kattlelattle/kindle-page-turner/hardware/pcb/rx/rx_bom.xlsx

Name | Description | Designator | Footprint | LibRef | Quantity
EEUFR1A102L | Aluminum electrolytic capacitor, 1000uF ±20%, 10V, radial | C1 | FP-RAD-TH-D_8_0_5-L_15_1-MFG | CMP-05427-001033-1 | 1
87224-3 | 3-position vertical male header, 2.54mm pitch, through-hole | J1 | FP-87224-3-MFG | CMP-2000-05697-2 | 1
Seeed Studio XIAO ESP32-C3 | ESP32-C3 development board with Wi-Fi and BLE | U1 | MOUDLE14P-2-54-21X17-8MM | Seeed Studio XIAO ESP32-C3 | 1
Adafruit MiniBoost 5V 1A | TPS61023 boost-converter breakout for servo power | U2 | PCBCOMPONENT_1 | Adafruit MiniBoost 5V 1A | 1
1x7 Female Socket Header, 2.54mm | Single-row 7-position female socket header, through-hole | — | 1x7 THT, 2.54mm pitch | TBD | 2
