kattlelattle/kindle-page-turner/hardware/pcb/tx/tx_bom.xlsx

Line # | Name | Description | Designator | Revision ID | Revision State | Revision Status | Quantity | Manufacturer 1 | Manufacturer Part Number 1 | Manufacturer Lifecycle 1 | Supplier 1 | Supplier Part Number 1 | Supplier Unit Price 1 | Supplier Subtotal 1
 | B3F-4000 | SWITCH TACTILE SPST-NO 0.05A 24V | SW1 |  | Unknown server |  | 1 | Omron | B3F-4000 | Volume Production | RS (Formerly Allied Electronics) | B3F-4000 | 0.22 | 0.22
 | Seeed Studio XIAO ESP32-C3 | Wi-Fi/BLE development board | U1 |  | Not managed |  | 1 | Seeed Studio | 113991054
 | 3.7 V 400 mAh LiPo | Rechargeable LiPo battery |  |  |  |  | 1
