kattlelattle/kindle-page-turner/hardware/enclosure/rx/rx_arm.stl

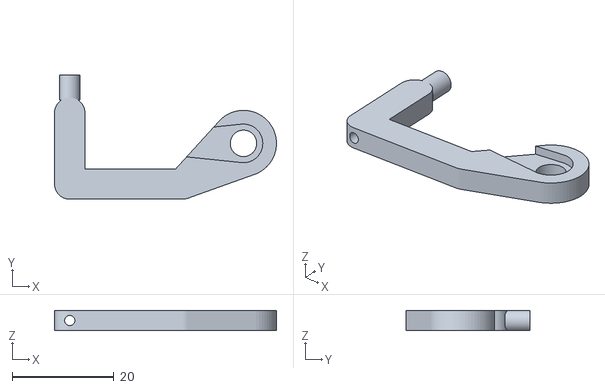
[picture p6: CAD file, 2026-11-07]
hardware/enclosure/rx/rx_arm.stl
43.7 x 24.5 x 4.00
