kattlelattle/kindle-page-turner/hardware/enclosure/tx/tx_lid.stl

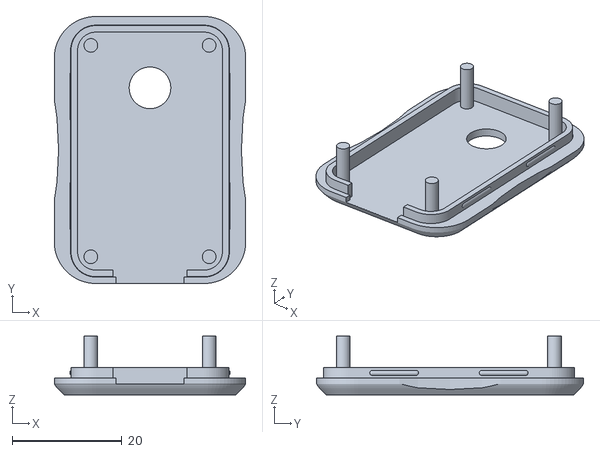
[picture p7: CAD file, 2026-11-07]
hardware/enclosure/tx/tx_lid.stl
35.0 x 48.8 x 10.7
