kattlelattle/kindle-page-turner/hardware/enclosure/rx/rx_body.stl

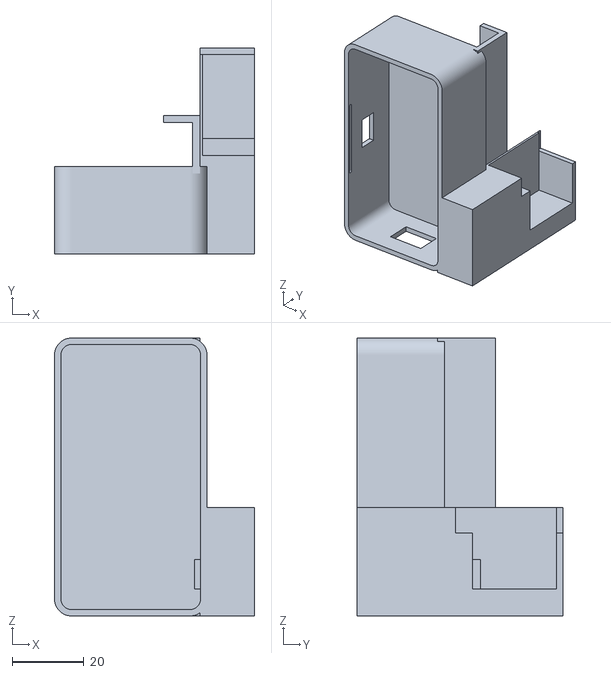
[picture p8: CAD file, 2026-11-07]
hardware/enclosure/rx/rx_body.stl
55.8 x 57.5 x 77.6
