kattlelattle/kindle-page-turner/hardware/enclosure/tx/tx_tray.stl

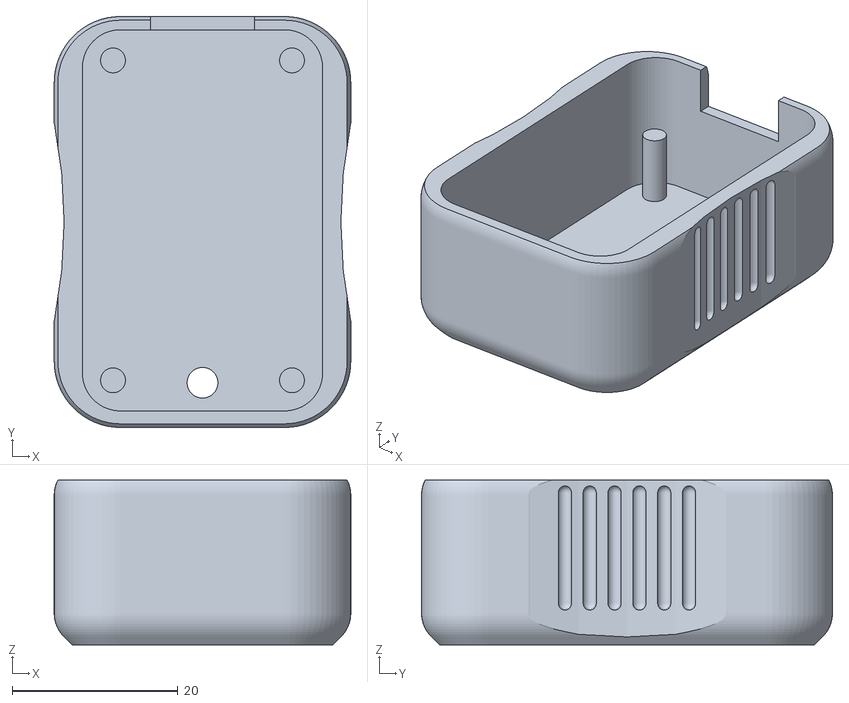
[picture p9: CAD file, 2026-11-07]
hardware/enclosure/tx/tx_tray.stl
35.8 x 49.6 x 19.9
