kattlelattle/kindle-page-turner/hardware/enclosure/rx/rx_lid.stl

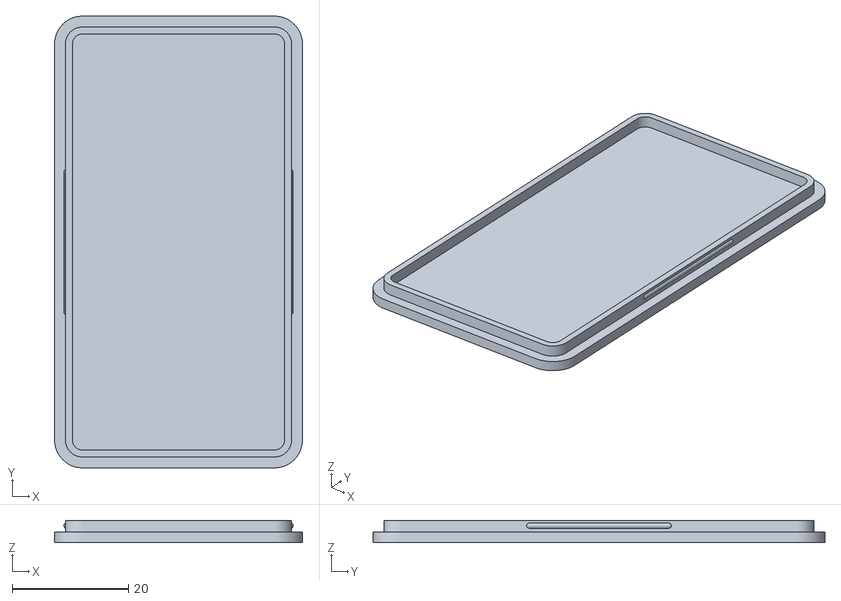
[picture p10: CAD file, 2026-11-07]
hardware/enclosure/rx/rx_lid.stl
42.6 x 77.6 x 3.80
