kattlelattle/kindle-page-turner/hardware/enclosure/tx/tx_button.stl

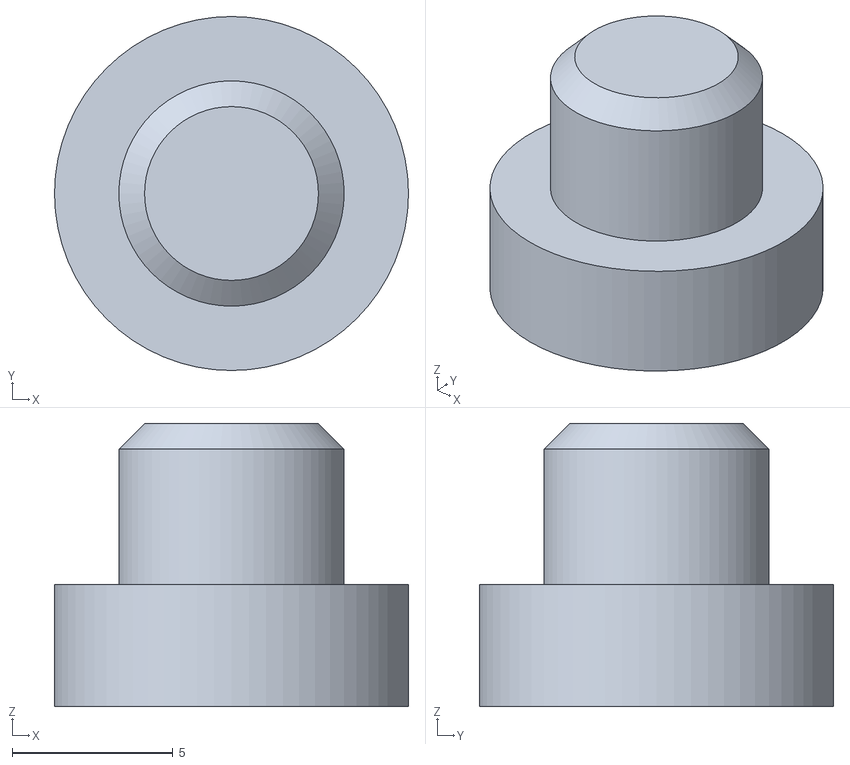
[picture p11: CAD file, 2026-11-07]
hardware/enclosure/tx/tx_button.stl
11.0 x 11.0 x 8.80
