kattlelattle/kindle-page-turner/hardware/pcb/rx/rx_schematic.pdf

# _OUTSolder pad

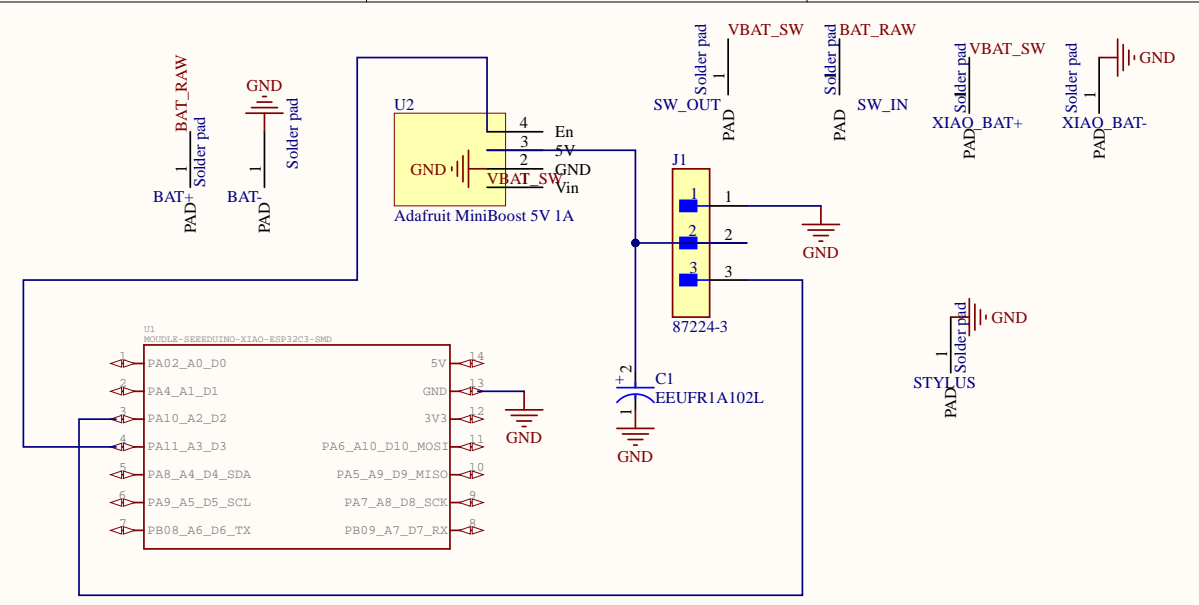
[picture p12: page 1]
Title; Size; Revisio; Date:; Sheet o; File:; C:\Users\..\Kin; dle_; RX.SchDo; Drawn B; PA8_A4_D4_SDA; PA9_A5_D5_SCL; PA7_A8_D8_SCK; PA5_A9_D9_MISO; PA6_A10_D10_MOSI; GND; Vin; GND 2; Adafr; uit MiniB; ost 5; 1 EEUFR; PAD 1; Solder pad; BAT; RAW; XIAO_; STYLUSSolder pad
