kattlelattle/kindle-page-turner/hardware/pcb/tx/tx_schematic.pdf

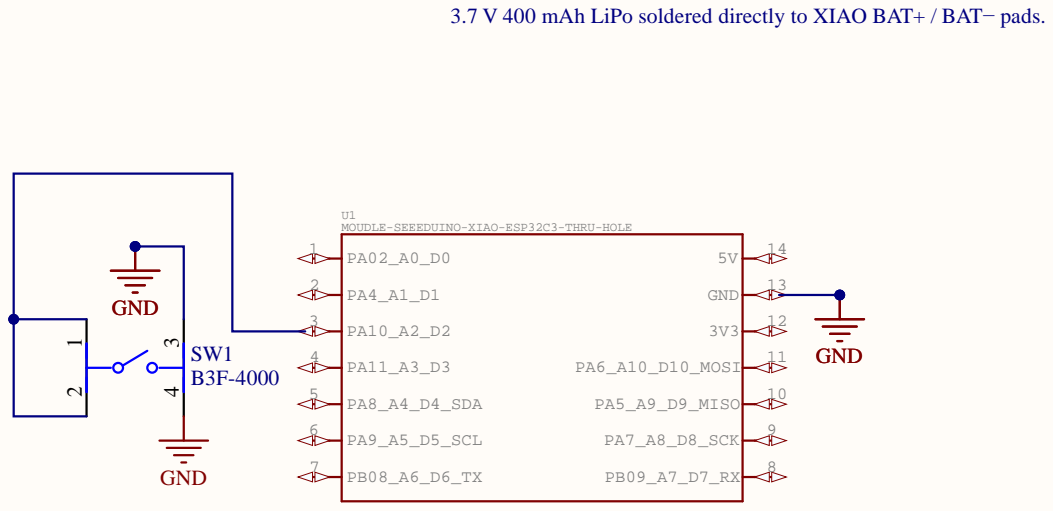
[picture p13: page 1]
Title; Size; Revisio; Date:; Sheet o; File:; Drawn B; PA8_A4_D4_SDA; PA9_A5_D5_SCL; PA7_A8_D8_SCK; PA5_A9_D9_MISO; PA6_A10_D10_MOSI; GND; − pads.

0 mAh LiPo soldered directly to XIAO B

C:\Users\..\TX Schematic.SchDo
