kattlelattle/kindle-page-turner/(list of files, drawings)

Other design files:
hardware/pcb/rx/altium/Kindle Page Turner RX.PrjPcb
hardware/pcb/rx/altium/Kindle_RX.PcbDoc
hardware/pcb/rx/altium/Kindle_RX.SchDoc
hardware/pcb/tx/altium/Kindle Page Turner TX.PrjPcb
hardware/pcb/tx/altium/Kindle_TX.PcbDoc
hardware/pcb/tx/altium/TX Schematic.SchDoc
