kattlelattle/kindle-page-turner/(commit log)

2026-09-16 Revise README with detailed project information
    Updated project description and added sections for overview, system architecture, PCB design, CAD, firmware, current status, and technologies.
2026-09-16 Revise README for improved clarity and structure
    Updated README for clarity and conciseness, revised sections on hardware design, PCB design, mechanical design, firmware, and project status.
2026-11-06 Add TX and RX PCB files
2026-11-07 Add enclosure STL files
2026-11-09 Update servo angle comment
2026-11-09 Update battery life estimates
2026-11-09 Update latency and battery estimates
2026-11-09 Reword battery life notes
